leoss-wc/PTR1_Project_ALLFILE/docs/Control_board_drawio.png

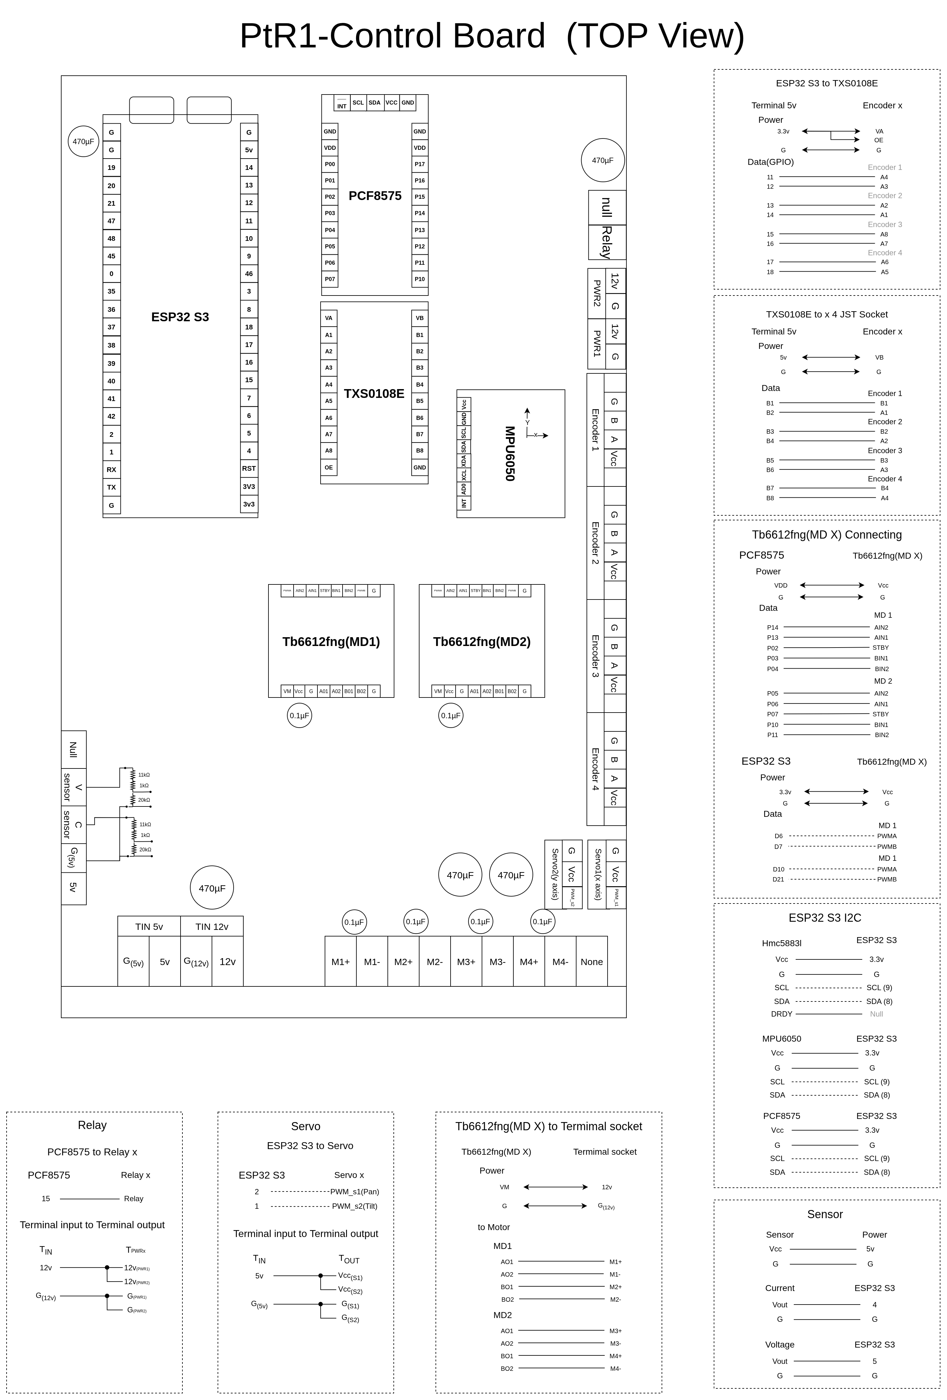
docs/Control_board_drawio.png
