leoss-wc/PTR1_Project_ALLFILE/docs/ptR1_control_board.jpg

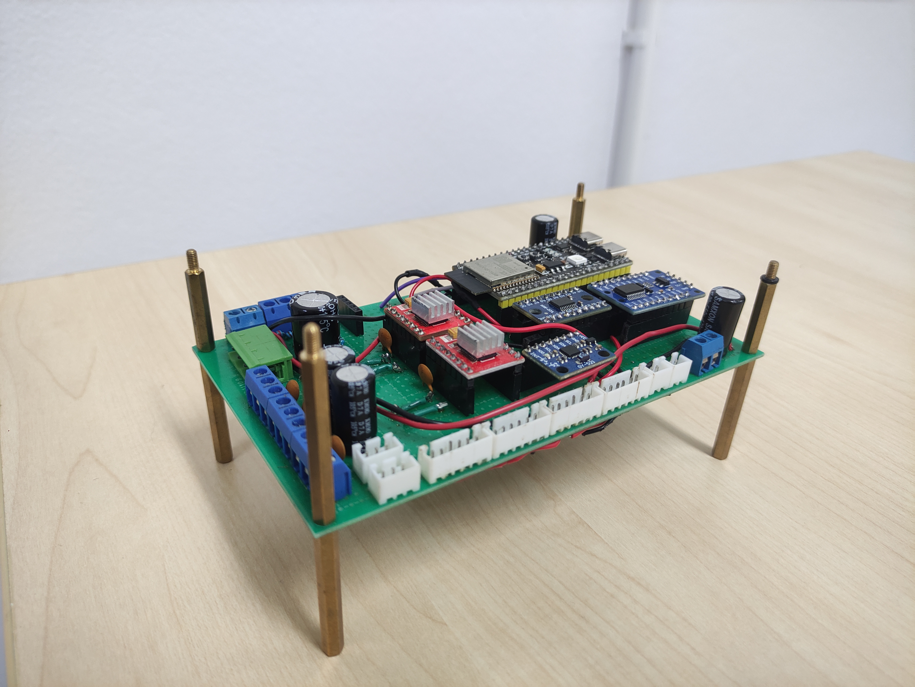
docs/ptR1_control_board.jpg
